GuppyTrix/Comp208/documentation/Images/Full design.png

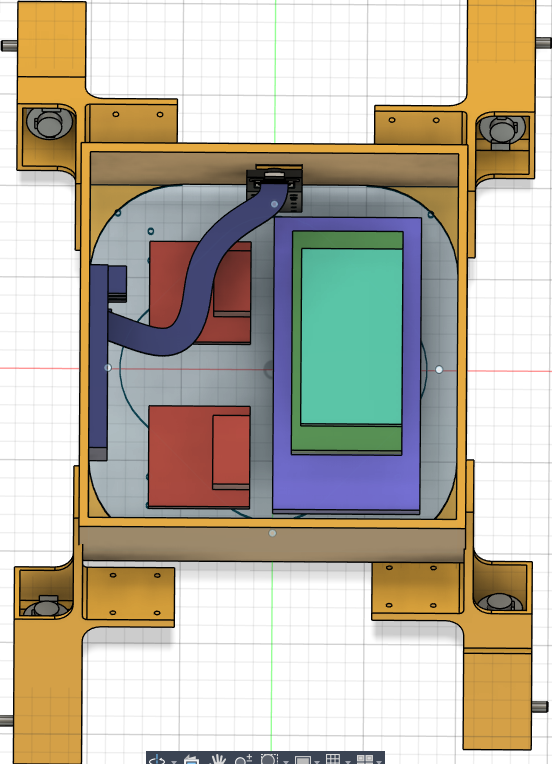
documentation/Images/Full design.png
