GuppyTrix/Comp208/CAD/readme.md

# CAD

Please add Fusion Files and screenshots/exported images of completed designs
