GuppyTrix/Comp208/code/readme.md

# Code

Please include all code files in the form of C++ (Arduino INO) and/or Python or Micropython files.
