GuppyTrix/Comp208/documentation/readme.md

# Documentation

Please add videos and images of your robot prototype here.
