GuppyTrix/Comp208/poster/poster trial.docx

Part D

Formative Poster Submission

Part D is a single formative submission consisting of a poster that explains your mobile robot. The poster should explore the following elements:

Locomotion

How do you plan to make your robot move?

What experiments with engineering and materials will you undertake to achieve effective movement?

Sensing & Navigation

How will your robot sense its environment?

How will it interpret feedback from its sensors to adapt or change its behaviour in order to achieve its goals?

Analysis

How will you analyse the data produced by your robot to enable rapid, iterative development?

What tools will you use to perform this analysis?

What data will you use to determine how well your robot operates?

Research

Demonstrate your understanding of key concepts in Robotics and Cybernetics, and explain how they are embedded in your project.

Include quotations and references to your research, using IEEE citations from at least three academic papers or other scholarly sources.

You should also include some or all of the following elements:
i. Diagrams
ii. Mathematical notation
iii. Algorithms
iv. Engineering and CAD designs

Note: Your research should be presented both in your poster and in your repository README.

Materials

What components and materials are needed to build your robot?

How do you plan to select, source, and construct with these materials?

# Abstract

Ever lost your can of coke, had no idea where to find it. Here with the Can finder It stores images of your can and using a camera won't stop until it finds it. Whether it's outside, inside or in the glove department the Can Finder won't stop until it finds it.
