GuppyTrix/Comp208/poster/JarethSubmissionStuff/Poster_For_Comp_208_Scrabbling.pdf

# Autonomous Rough-Terrain Robot for Object Retrieval

# Scrabbling Contract Implementation

# Jareth Haydon-Guppy

# COMP208: Robotics & Cybernetics Falmouth University

# Abstract

This project addresses the Scrabbling Contract challenge: designing an autonomous robot capable of navigating rough outdoor terrain (grass and rubble across 15m²
) to locate a drink can, report arrival, and return to its starting point. The robot employs a four-wheel drive system with foam-filled rubber RC wheels powered by 12V DC motors (1:64 gear reduction, 40RPM) for optimal terrain adaptability. Using a Raspberry Pi 5 with Pi Camera Module 3 and OpenCV-based color detection, the robot identifies red cans with high accuracy. A Finite State Machine (FSM) architecture controls autonomous navigation with encoder-based odometry for precise movement tracking. The system successfully demonstrates cybernetic principles of feedback and goal-oriented behavior in unstructured environments.

Figure 1: Final Design of the robot

# Introduction & Contract Overview

- Contract: Scrabbling - Navigating rough outdoor terrain to locate and approach a drink can
- Environment: 15m² arena with grass and rubble (chaotic, changing surface)
- Primary Goal: Autonomously locate and approach a vertical drink can
- Secondary Goal: Return to starting point and signal task completion
- Key Constraint: Fully autonomous operation with error reporting
- Cybernetic Focus: Feedback loops for environmental adaptation and goal achievement

# Research & Theoretical Framework

- Cybernetics Principle: "For any machine subject to a varied external environment to act effectively information concerning the results of its own action must bebe furnished to it as part of the information on which it must continue to act." - Norbert Wiener
- Sensor Fusion Theory: Integration of visual (camera) and proprioceptive (encoder) feedback for robust perception
- Finite State Machines: Formal method for autonomous behavior sequencing and decision-making
- Computer Vision: Color space analysis and object detection in unstructured environments [1]

# Materials & Fabrication

- Core Components:

– 4 × 12V DC motors with built-in encoders (1:64 worm gear, 100RPM)
– 2 × L298N H-bridge motor drivers
– Arduino Mega 2560 microcontroller
– Raspberry Pi 5 with Pi Camera Module 3 – 12V LiPo battery pack
– 4 × Foam-filled rubber RC wheels
- Custom Fabrication:

– 3D-printed motor mounts and wheel adapters (Fusion 360)
– Acrylic base plate with custom mounting points – 3D-printed protective enclosure for electronics – Custom dimension documentation for encoder motors
- Fasteners: M3 bolts and nuts throughout assembly

# Technical Implementation

## Locomotion System

Wheel Selection: Foam-filled rubber RC wheels provide optimal traction on uneven surfaces without pneumatic complications. Motor Configuration: 12V DC motors with 1:64 gear reduction deliver 100RPM with high torque for rough terrain. Drive Train: Direct drive connection via 3D-printed adapters (no belts or additional gearing). Design Rationale: Four-wheel distribution minimizes individual axle load; direct drive simplifies mechanical design while maintaining sufficient torque.

## Sensing & Computer Vision

- Vision System: Raspberry Pi 5 with Pi Camera Module 3
- Detection Algorithm:
1. Colour space conversion to HSV for robust red color detection
2. Morphological operations to reduce noise
3. Contour detection and aspect ratio validation (0.7-1.2 tolerance for angled cans)
4. Three-frame verification with 0.2s intervals to prevent false positives
5. Bounding box area threshold for arrival determination
- Search Pattern: Systematic left-right scanning with periodic stops for clear image capture
- Future Enhancement: Ultrasonic sensor integration for tree/obstacle detection

## Control Architecture

- Three-Class System: Robot class: High-level control methods, FSM class: Finite State Machine for behaviour sequencing and Odometry class: Encoder-based position tracking (4 instances, one for each motor)
- State Machine Design:
Searching | Homing

Arrived

Can detected

Lost target

Area threshold reached

Reset activated

- Communication Protocol: GPIO pins (left, right, found, arrived) between RPi and Arduino
- Precision Movement: Encoder-based turning and distance measurement for accurate navigation

## Odometry Calculation

- D = Wheel diameter
- N = Encoder ticks per revolution
- G = Gear Ratio
- E = Encoder Resolution
- L = Wheelbase distance
- θ = Robot orientation
- C = Wheel Circumference

Ticks per degree =

G × E
360

=

63 × 44
360

=

2772
360

= 7.7 ticks/°

Distance per degree =

C
360

=

100π
360

≈ 0.8727 mm/°

Distance per tick =

C
G × E

=

100π
63 × 44

=

100π
2772

≈ 0.1133 mm/tick

### Color Detection Algorithm:

Convert RGB to HSV colour space
Apply threshold for red hues: H ∈ [0, 10] ∪ [170, 180] Find contours and calculate bounding boxes Filter by aspect ratio: 1.2 ≤

w
h ≤ 1.3
Time-based three-frame verification

# Analysis & Iterative Development

- Prototyping Phases:
1. Initial testing with various wheel sizes and flanges on 8mm rods
2. Gear reduction experiments (1:2.5 custom gearing, belt systems)
3. Final design: Direct drive with custom 3D-printed adapters
- Data Collection:
– Detection accuracy under varying lighting conditions
– Terrain navigation success rates on grass, rubble, loose leaves, mud, apples – Encoder accuracy and odometry drift correction
- Iterative Improvements:
– Added three-frame verification to reduce false positives
– Implemented aspect ratio tolerance for consistent and angled detection
– Refined state transitions based on field testing
In Figure 2 i have a design of the robot color coded for easy description of the parts in the robot the Yellow is the case of the robot designed to hold all of the parts together including the encoders. The Red are the H-Bridges which control the motors wheel direction. there are cables connected to the motors and to the Arduino. The light blue is the Arduino, we used an Arduino Mega 2560 in this project. The green is the NI-MH battery pack that was used to power the motors as the power from the Arduino would not be high enough and the purple box underneath the green box is the battery pack used to power the Arduino and The Raspberry Pi. The Raspberry Pi can be seen as the dark purple which had a connector to the camera module at the front of the robot

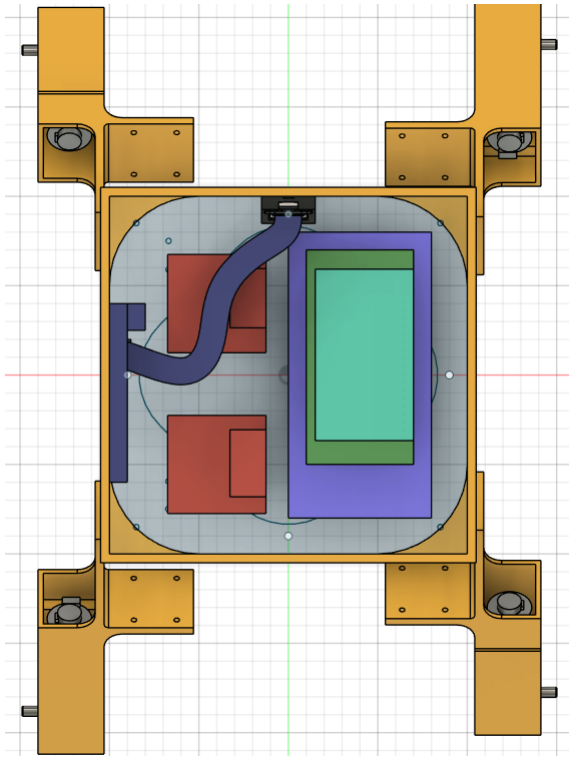
[picture p2: figure]

Figure 2: Full Robot Design in CAD colour coded

# Results & Evaluation

## Key Achievements

- Successfully located cans in trials under good lighting
- Robust detection with three-frame verification system
- Precise encoder-based movement control with odometry tracking
- Clear arrival signaling with buzzer activation

## Design Decisions & Rationale

- Foam-filled wheels: Eliminated pneumatic maintenance while maintaining traction
- Direct drive: Simplified mechanical design with sufficient torque for terrain
- Dual-processor architecture: Arduino for real-time motor control, RPi for computer vision
- State machine design: Clear separation of behaviors with defined transitions
- Three-frame verification: Balanced responsiveness with noise immunity

# Conclusion

The Scrabbling Contract robot successfully demonstrates the application of cybernetic principles to autonomous navigation in unstructured environments. Key achievements include robust can detection using computer vision, precise encoder-based navigation, and a reliable state machine architecture. The robot meets all contract requirements while employing sustainable design practices through 3D printing and component reuse. Future enhancements could include ultrasonic obstacle avoidance, wireless telemetry for status reporting, and machine learning for improved object recognition.

# Acknowledgments

Thanks to the COMP208 teaching team for technical guidance and access to fabrication facilities. Special thanks to Freddie for collaborative design iterations and some excellent ideas. Fusion 360 was used for CAD design under educational license.

# References

[1] F. Neha, D. Bhati, D. K. Shukla, and M. Amiruzzaman, “From classical techniques to convolution-based models: A review of object detection algorithms,” arXiv, Dec. 2024. DOI: 10.48550/arXiv.2412.05252. [Online]. Available: https://arxiv.org/abs/2412.05252.
