GuppyTrix/Comp208/CAD/Camera/Body1.stl

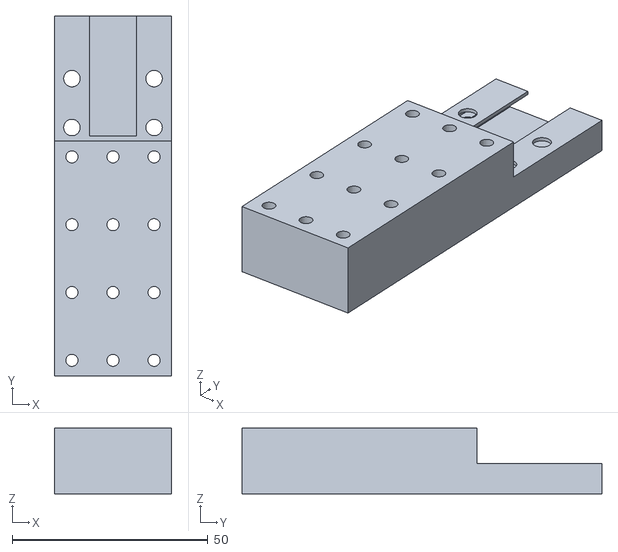
[picture p3: CAD file, 2025-12-11]
CAD/Camera/Body1.stl
30.0 x 92.0 x 16.8
