GuppyTrix/Comp208/CAD/Gears & Wheels/Gear Tolerances.stl

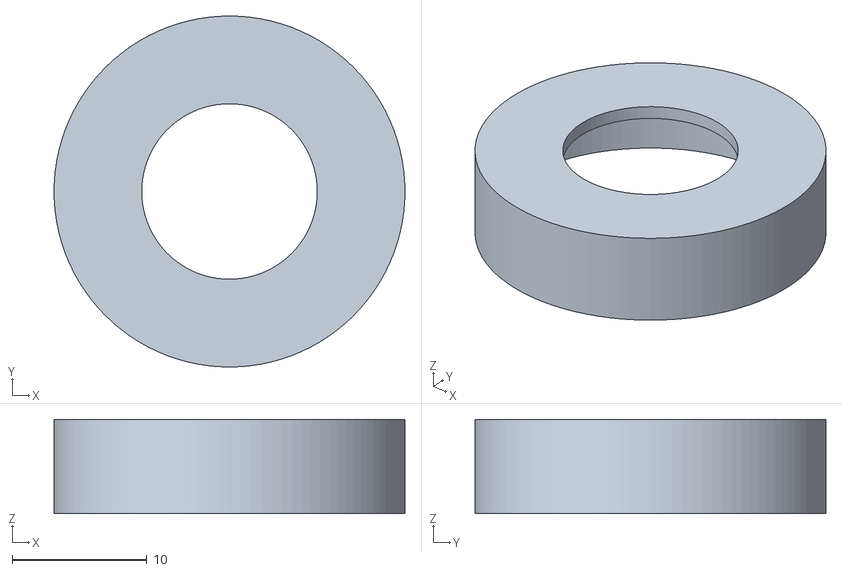
[picture p4: CAD file, 2025-11-27]
CAD/Gears & Wheels/Gear Tolerances.stl
26.0 x 26.0 x 7.00
