GuppyTrix/Comp208/CAD/LDR Casing v3.stl

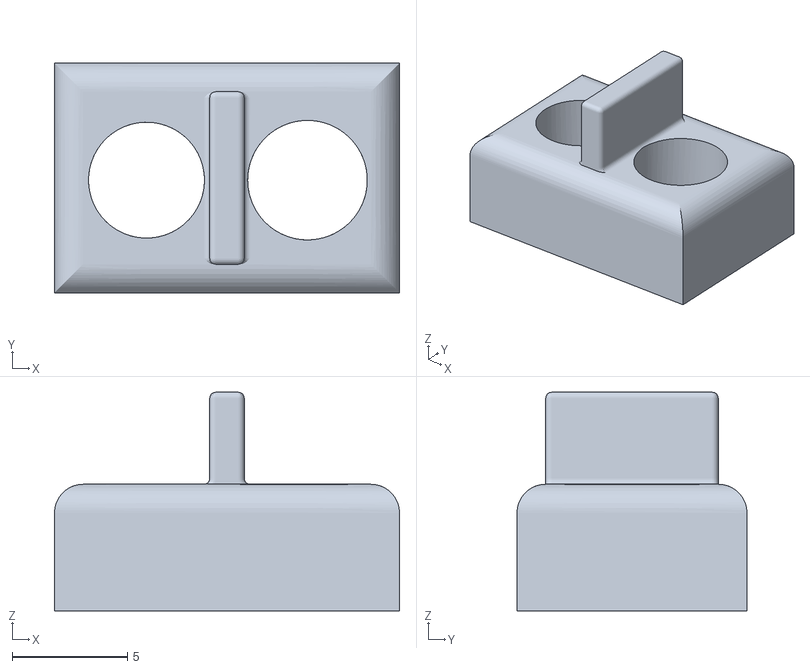
[picture p5: CAD file, 2025-11-06]
CAD/LDR Casing v3.stl
15.0 x 10.0 x 9.50
