GuppyTrix/Comp208/CAD/Motors/Encoder Clearance Holder.stl

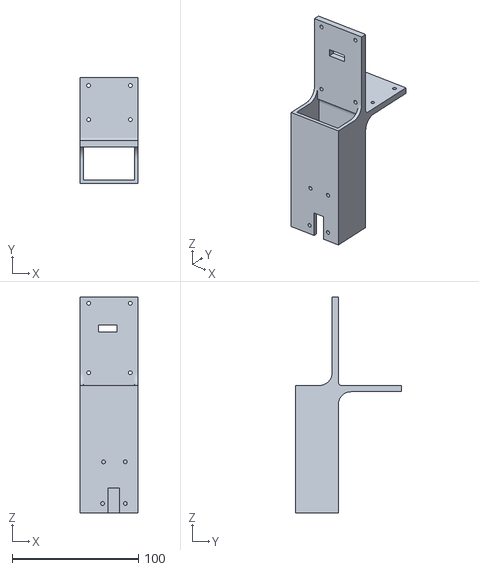
[picture p6: CAD file, 2025-12-09]
CAD/Motors/Encoder Clearance Holder.stl
46.0 x 84.0 x 171.0
