GuppyTrix/Comp208/CAD/Motors/motor holder.3mf

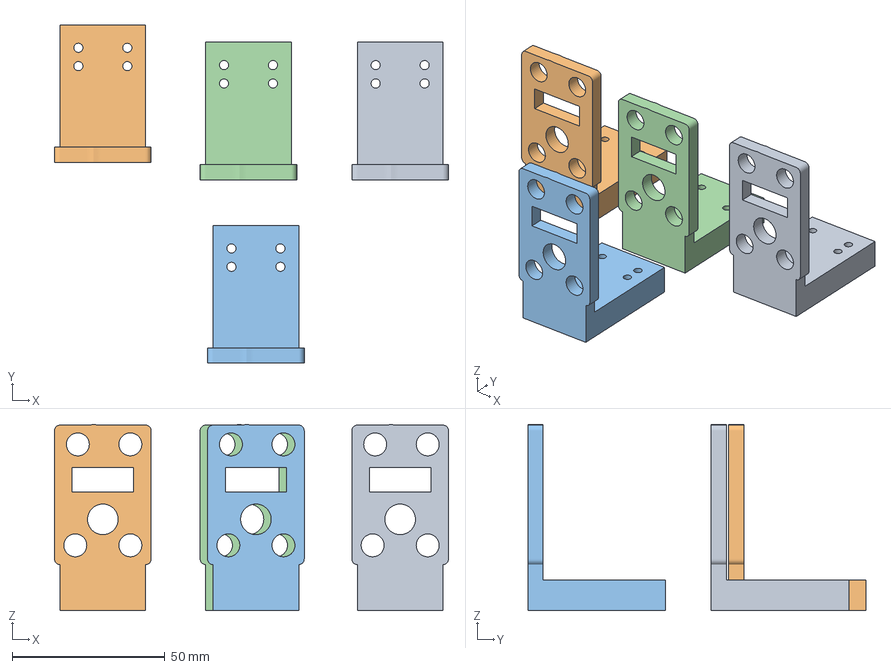
[picture p7: CAD file, 2025-12-03]
CAD/Motors/motor holder.3mf
128.8 x 110.6 x 60.8 mm
motor holder.stl x 4
