GuppyTrix/Comp208/CAD/Motors/207 base.dxf

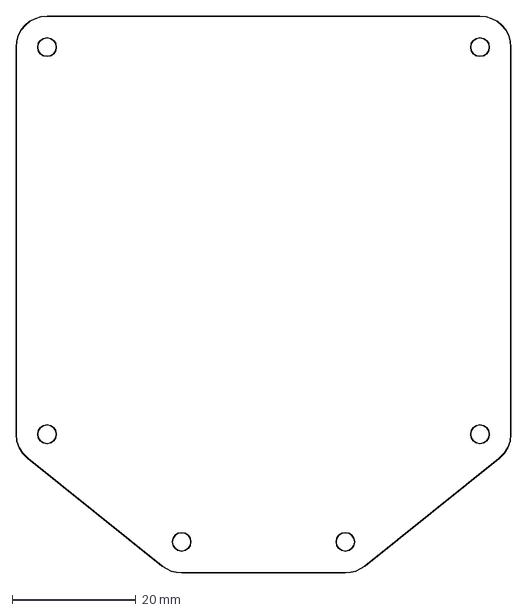
[picture p8: CAD file, 2025-11-29]
CAD/Motors/207 base.dxf
80.0 x 90.0 mm
