GuppyTrix/Comp208/CAD/Motors/finalized jareth version.3mf

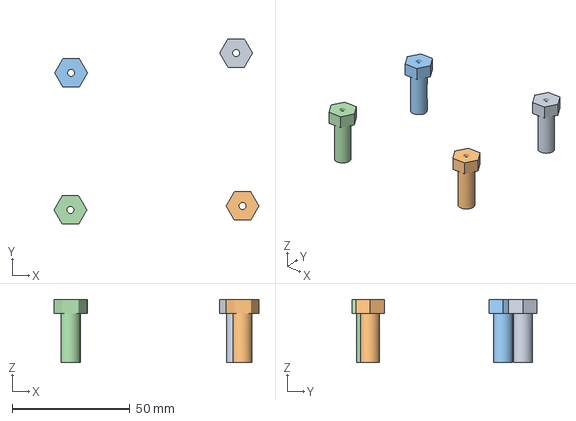
[picture p9: CAD file, 2025-11-29]
CAD/Motors/finalized jareth version.3mf
87.2 x 78.9 x 27.0 mm
finalized jareth version.stl x 4
