GuppyTrix/Comp208/CAD/Motors/encoder holder.dxf

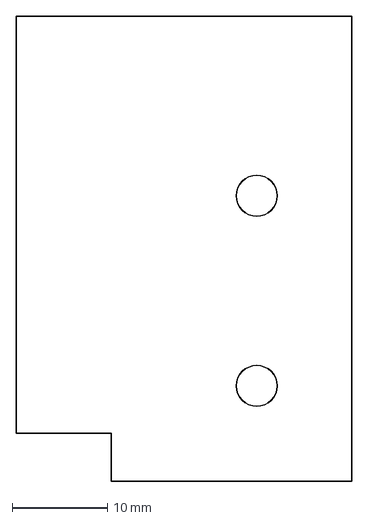
[picture p10: CAD file, 2025-11-27]
CAD/Motors/encoder holder.dxf
35.3 x 48.9 mm
