GuppyTrix/Comp208/CAD/Motors/smaller washer for holding in place.stl

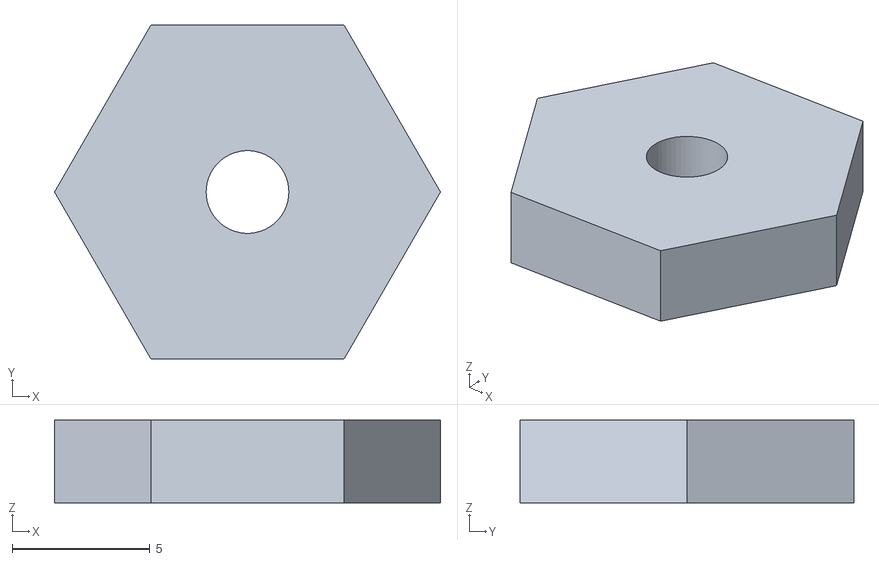
[picture p11: CAD file, 2025-12-03]
CAD/Motors/smaller washer for holding in place.stl
14.0 x 12.1 x 3.00
