GuppyTrix/Comp208/CAD/Motors/bolt for wheels.dxf

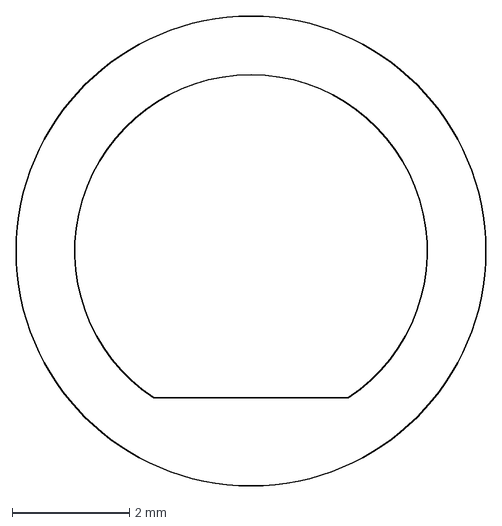
[picture p12: CAD file, 2025-11-27]
CAD/Motors/bolt for wheels.dxf
8.00 x 8.00 mm
