GuppyTrix/Comp208/(list of files, cad)

Other CAD files:
CAD/Motors/Wheel axel connector.f3d
CAD/Motors/motor holder.stl
CAD/shell/Full Box Design.f3z
CAD/shell/chassis take 2.f3z
