GuppyTrix/Comp208/poster/Jareth Submission stuff/Jareth-Comp-208-Devlog/Comp 208 devlog 2795be74c30880d0a1c4d0de6863eb3a.pdf

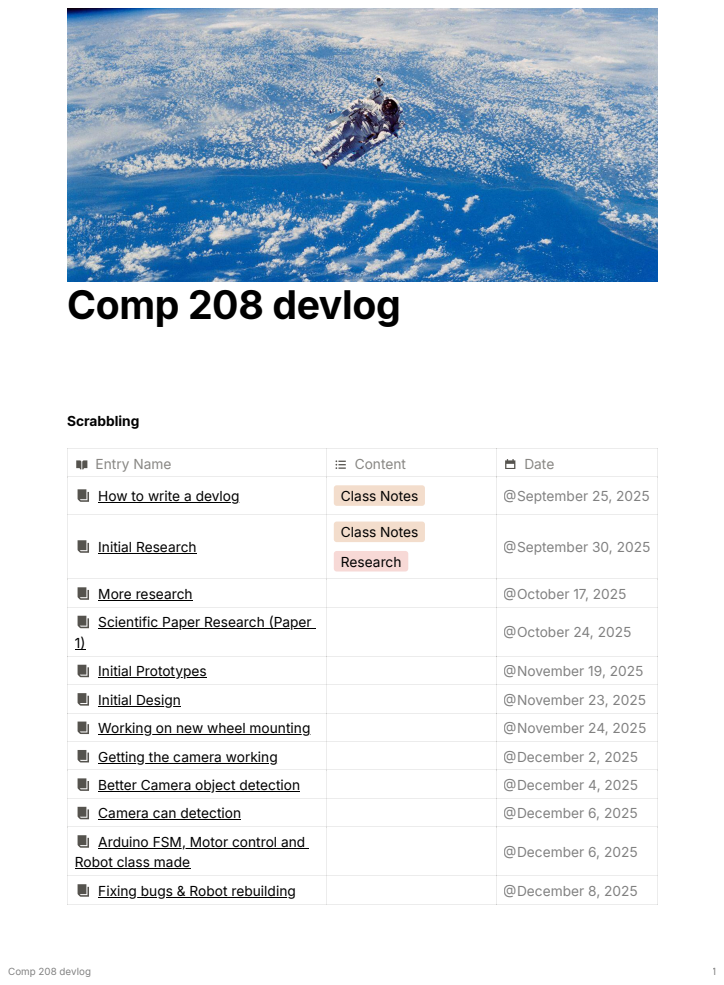
[picture p13: page 1]
Comp 208 devlog; Scrabbling; Entry Name; Content; Date; September 25, 2025 @; September 30, 2025 @; October 17, 2025 @; October 24, 2025 @; November 19, 2025 @; November 23, 2025 @; November 24, 2025 @; December 2, 2025 @; December 4, 2025 @; December 6, 2025 @; December 8, 2025 Comp 208 devlog

How to write a devlog (https://www.notion.so/How-to-write-a-devlog-2cb5be74c3088127a520ef2aea5b9929?pvs=21) | Class Notes

Initial Research (https://www.notion.so/Initial-Research-2cb5be74c308811fbf50c0e0c553caf0?pvs=21) | Class Notes Research

More research (https://www.notion.so/More-research-2cb5be74c3088161baeeeb874f951d66?pvs=21)
Scientific Paper Research (Paper 1) (https://www.notion.so/Scientific-Paper-Research-Paper-1-2cb5be74c30881739049ea7695071078?pvs=21)

Initial Prototypes (https://www.notion.so/Initial-Prototypes-2cb5be74c30881e589d9d2a5f8bcf9ee?pvs=21)
Initial Design (https://www.notion.so/Initial-Design-2cb5be74c30881f289c0d6c7474cb86d?pvs=21)
Working on new wheel mounting (https://www.notion.so/Working-on-new-wheel-mounting-2cb5be74c308814c9904e42dfc15a79c?pvs=21)
Getting the camera working (https://www.notion.so/Getting-the-camera-working-2cb5be74c30881e691eae9727fa10bfa?pvs=21)
Better Camera object detection (https://www.notion.so/Better-Camera-object-detection-2cb5be74c30881c382dce5bf9b646814?pvs=21)
Camera can detection (https://www.notion.so/Camera-can-detection-2cb5be74c308819abd0ff79c5a6959ca?pvs=21)
Arduino FSM, Motor control and Robot class made (https://www.notion.so/Arduino-FSM-Motor-control-and-Robot-class-made-2cb5be74c3088186947fe69ddc9f02ba?pvs=21)

Fixing bugs & Robot rebuilding (https://www.notion.so/Fixing-bugs-Robot-rebuilding-2cb5be74c30881989d82fe625edd5869?pvs=21)

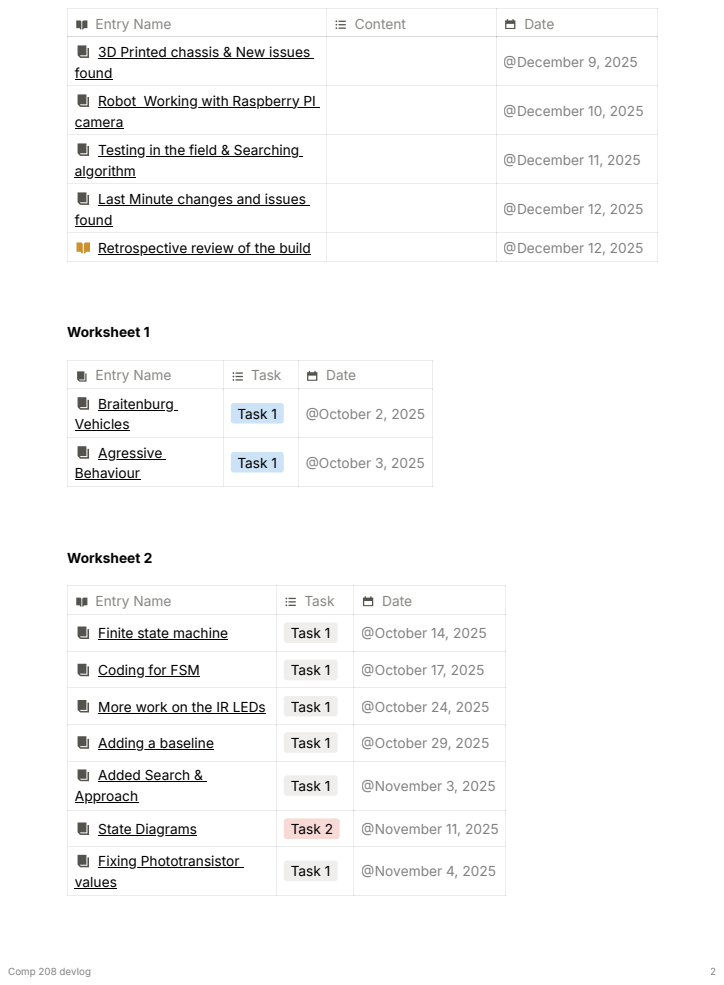
[picture p14: page 2]
Entry Name; Content; Date; Worksheet 1; Task; Worksheet 2; December 9, 2025 @; December 10, 2025 @; December 11, 2025 @; December 12, 2025 @; October 2, 2025 @; October 3, 2025 @; October 14, 2025 @; October 17, 2025 @; October 24, 2025 @; October 29, 2025 @; November 3, 2025 @; November 11, 2025 @; November 4, 2025 Comp 208 devlog

3D Printed chassis & New issues found (https://www.notion.so/3D-Printed-chassis-New-issues-found-2cb5be74c308816fa553f33e7964c2e2?pvs=21)

Robot Working with Raspberry PI camera (https://www.notion.so/Robot-Working-with-Raspberry-PI-camera-2cb5be74c30881d3b7e6e34f6371d449?pvs=21)

Testing in the field & Searching algorithm (https://www.notion.so/Testing-in-the-field-Searching-algorithm-2cb5be74c30881fa8cadfc72ab0cecde?pvs=21)

Last Minute changes and issues found (https://www.notion.so/Last-Minute-changes-and-issues-found-2cb5be74c30881509e6dfeeaff751a58?pvs=21)

Retrospective review of the build (https://www.notion.so/Retrospective-review-of-the-build-2cb5be74c30881d6a68cfc4c6df7d66f?pvs=21)

Braitenburg Vehicles (https://www.notion.so/Braitenburg-Vehicles-2cb5be74c30881de8a02ed7190a3dbe6?pvs=21) | Task 1

Agressive Behaviour (https://www.notion.so/Agressive-Behaviour-2cb5be74c308810ebce8c4f3feee3c0c?pvs=21) | Task 1

Finite state machine (https://www.notion.so/Finite-state-machine-2cb5be74c30881da9b71c4291b8a3b9e?pvs=21) | Task 1

Coding for FSM (https://www.notion.so/Coding-for-FSM-2cb5be74c3088121bc3ffe1077e5503e?pvs=21) | Task 1

More work on the IR LEDs (https://www.notion.so/More-work-on-the-IR-LEDs-2cb5be74c30881a88f6fd68fc78efd3e?pvs=21) | Task 1

Adding a baseline (https://www.notion.so/Adding-a-baseline-2cb5be74c3088156af89fa81c1183bad?pvs=21) | Task 1

Added Search & Approach (https://www.notion.so/Added-Search-Approach-2cb5be74c3088145ad69f88277c27439?pvs=21) | Task 1

State Diagrams (https://www.notion.so/State-Diagrams-2cb5be74c30881869922e9abde0b3912?pvs=21) | Task 2

Fixing Phototransistor values (https://www.notion.so/Fixing-Phototransistor-values-2cb5be74c308818eafd8fb7cb13e54e6?pvs=21) | Task 1

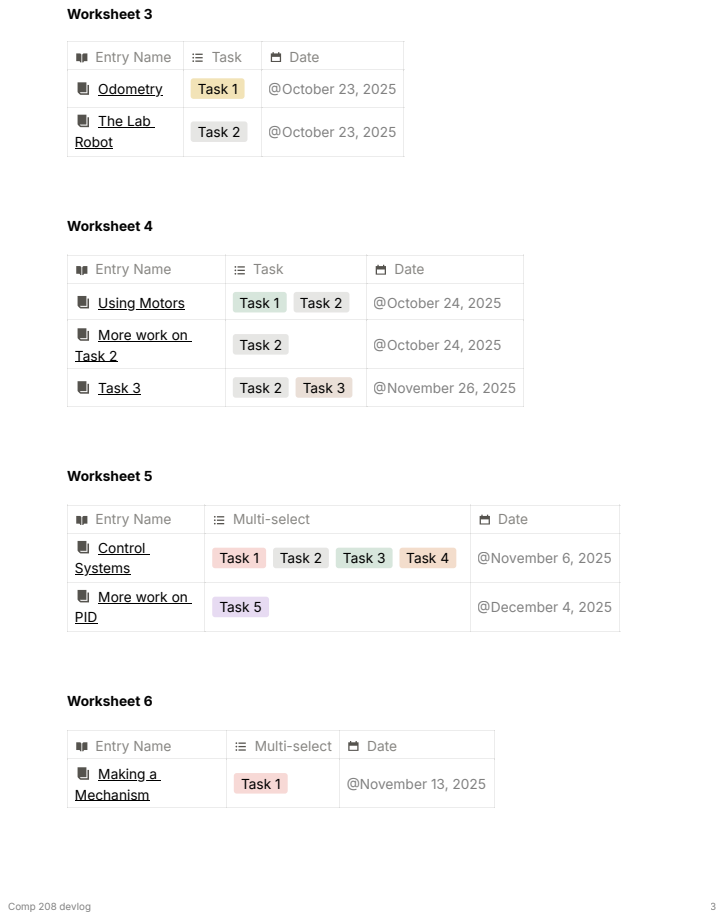
[picture p15: page 3]
Worksheet 3; Entry Name; Task; Date; Worksheet 4; Worksheet 5; Multi-select; Worksheet 6; Making a Mechanism; Task 1; October 23, 2025 @; October 24, 2025 @; November 26, 2025 @; November 6, 2025 @; December 4, 2025 @; November 13, 2025 Comp 208 devlog

Odometry (https://www.notion.so/Odometry-2cb5be74c30881599b50dfe5028639c8?pvs=21) | Task 1

The Lab Robot (https://www.notion.so/The-Lab-Robot-2cb5be74c30881e5b100f9c9e8f8b5f3?pvs=21) | Task 2

Using Motors (https://www.notion.so/Using-Motors-2cb5be74c3088183ab7cd6b2263e507f?pvs=21) | Task 1 Task 2

More work on Task 2 (https://www.notion.so/More-work-on-Task-2-2cb5be74c3088136b59acfd63b89363d?pvs=21) | Task 2

Task 3 (https://www.notion.so/Task-3-2cb5be74c308811babb4dfaad9edf8d2?pvs=21) | Task 2 Task 3

Control Systems (https://www.notion.so/Control-Systems-2cb5be74c30881e0a1ffcd1bb1e71592?pvs=21) | Task 1 Task 2 Task 3 Task 4

More work on PID (https://www.notion.so/More-work-on-PID-2cb5be74c30881fc9e27c2d834b5a0dd?pvs=21) | Task 5

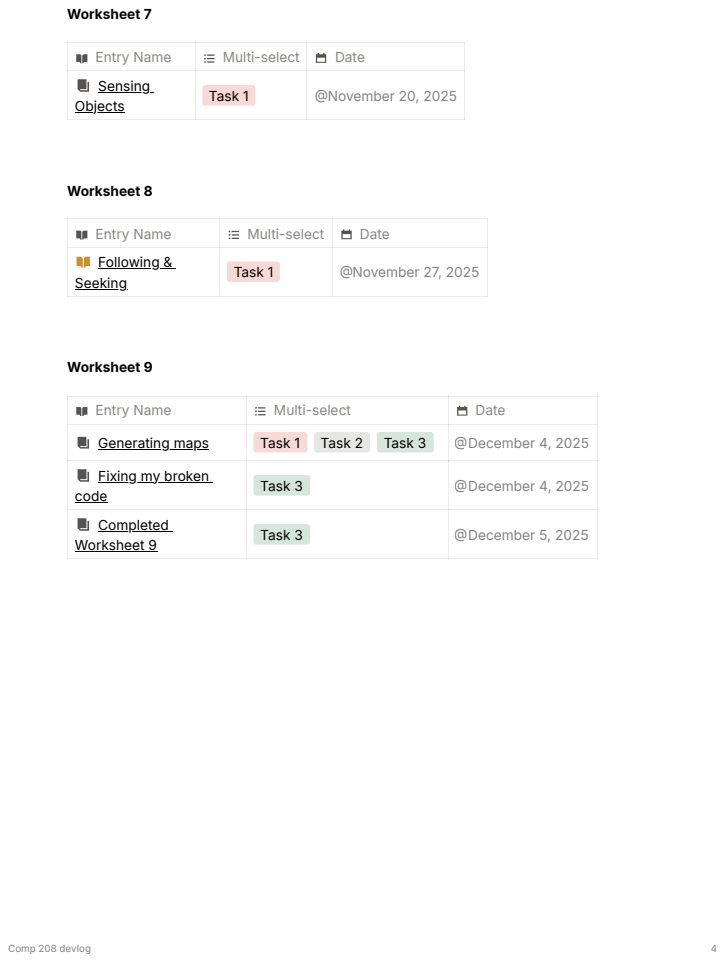
[picture p16: page 4]
Worksheet 7; Entry Name; Multi-select; Date; Sensing Objects; Task 1; Worksheet 8; Following & Seeking; Worksheet 9; November 20, 2025 @; November 27, 2025 @; December 4, 2025 @; December 5, 2025 Comp 208 devlog

Generating maps (https://www.notion.so/Generating-maps-2cb5be74c3088160a6dec0c7edc7d1f5?pvs=21) | Task 1 Task 2 Task 3

Fixing my broken code (https://www.notion.so/Fixing-my-broken-code-2cb5be74c30881e983cfed3376d3a736?pvs=21) | Task 3

Completed Worksheet 9 (https://www.notion.so/Completed-Worksheet-9-2cb5be74c308816a8a68fce99e161d9e?pvs=21) | Task 3
