GuppyTrix/Comp208/documentation/Schematic_208-wiring-diagram_2025-12-01.pdf

# GND +5V 5052 4749

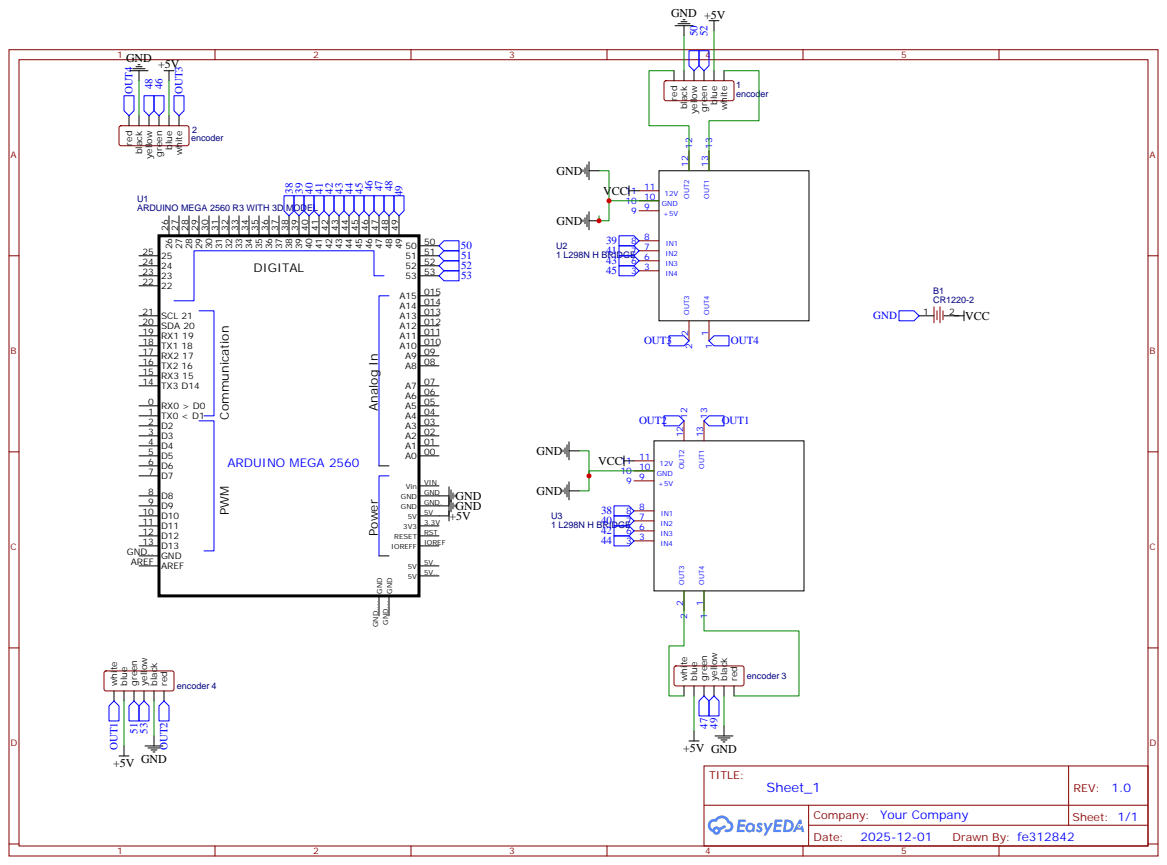
[picture p17: page 1]
