GuppyTrix/Comp208/CAD/Motors/12 volt motor holders Drawing v1.pdf

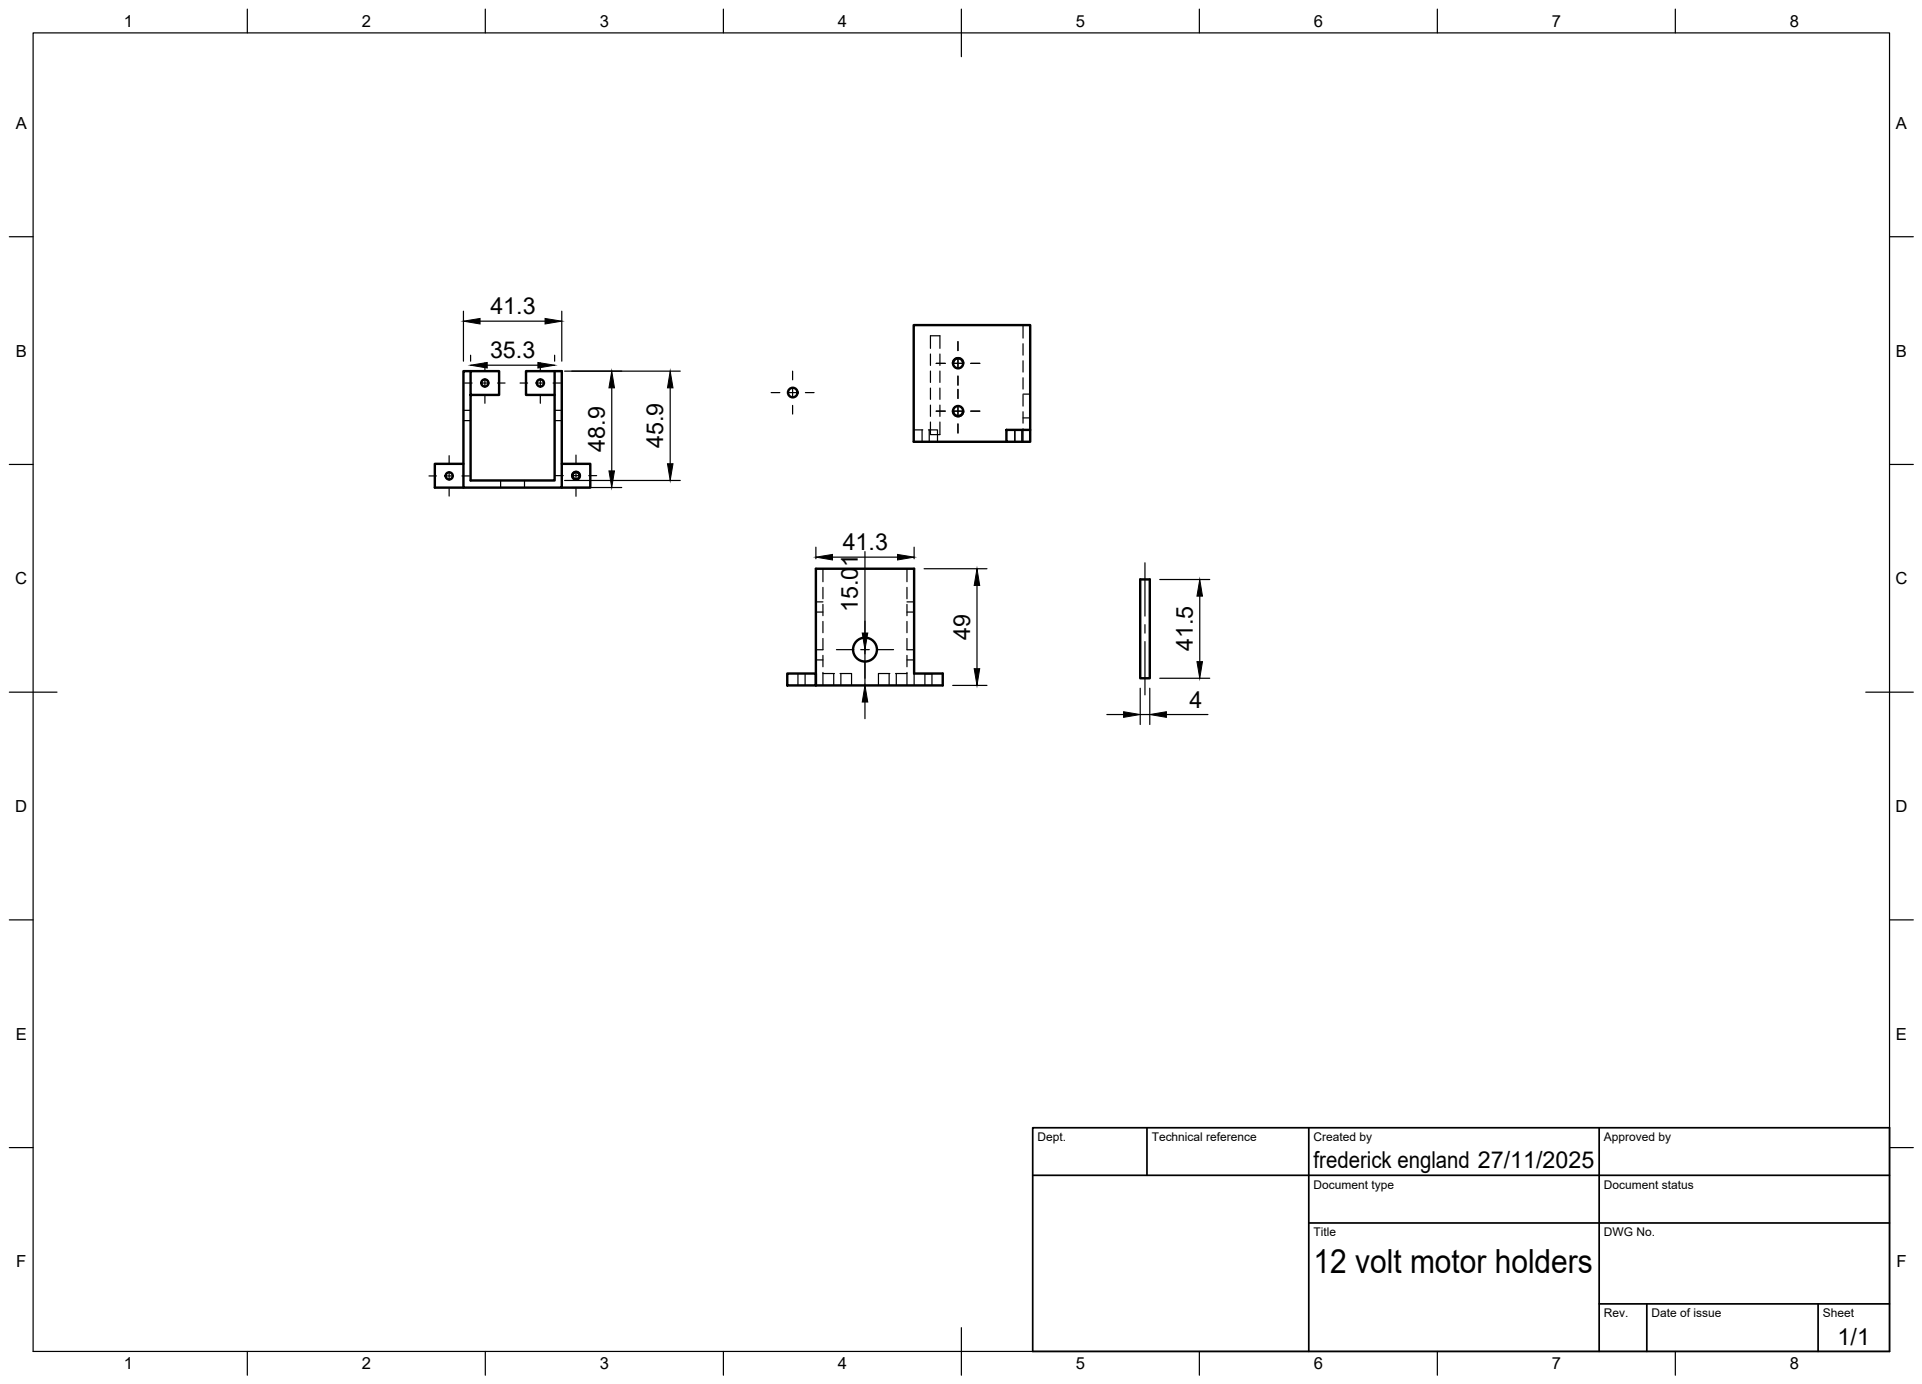
[picture p18: page 1]
Title; DWG No.; Rev.; Date of issue; Sheet; frederick england 15.01

Dept. | Technical reference | Created by 27/11/2025 | Approved by

Document type | Document status

12 volt motor holders
