GuppyTrix/Comp208/documentation/12v dc reduciton Motor Technical drawing.pdf

46 39 18

33 ³² 2 21 | 1412 | Ø13.4 | Ø25 Ø3 Ø7.5 ¹⁶

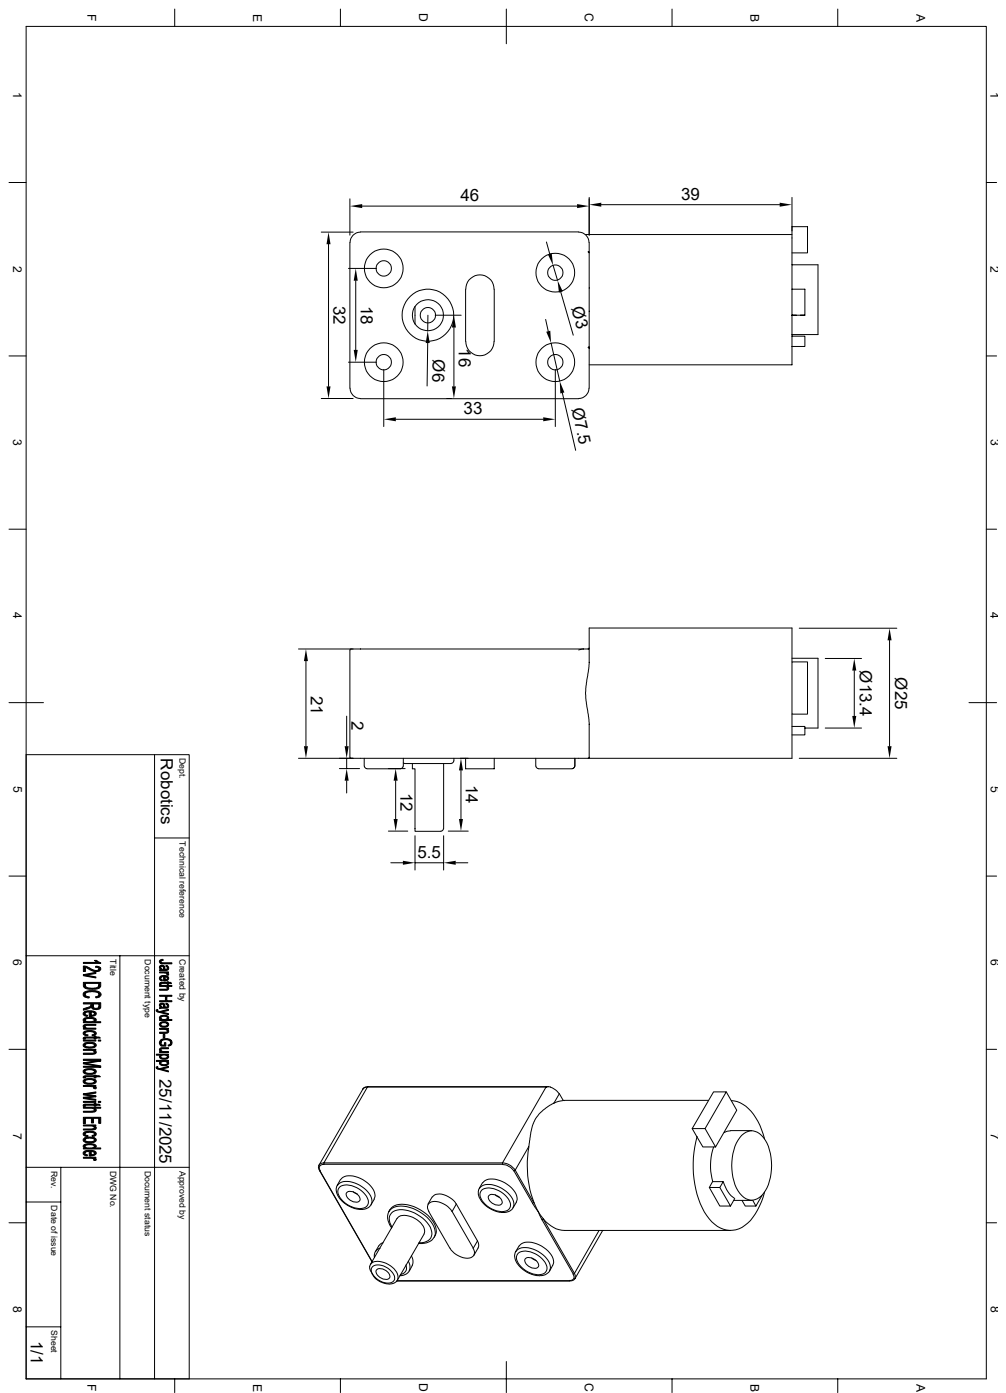
[picture p19: page 1]
5.5Ø6 Robotics

1 A 2 3 4 5 6 7 8 1 2 3 4 5 6 7 8 FEDCB FEDCBA Dept. Technical reference Created by Approved by Title DWG No. Document type Document status Rev. Date of issue Sheet 25/11/2025 1/1
