GuppyTrix/Comp208/(list of files, drawings)

Other design files:
CAD/SCH_208-Brab-Putt_2025-11-09.json
