GuppyTrix/Comp208/(commit log)

2025-10-23 Worked with Jareth on this rpm and torque calculation code
2025-11-06 Added: Phototransistor and IR led casing STL
2025-11-06 trialing BANGBANG code
    Added what i interpret currently as bang bang code
2025-11-06 Modified: completed the Bang Bang motor drive method
2025-11-09 trialing pcb design
2025-11-10 sent in some sample code that might help with task 5
2025-11-11 trying to get the code compiled
    since it's an arduino goign to a raspberry pi it's struggling to compile
2025-11-14 added velocity code and trying to get it to upload to lab bot
2025-11-20 Modidied: Simple state code
    added an avoid obstacle case to the state machine
2025-11-20 continued work on encoder practice
2025-11-20 Modified: moved torquecalc
2025-11-25 Added: modeled the 12v DC Motor
2025-11-27 added improved ultrasonic code
2025-11-27 modified the wall follwer code to use all 3 sensors
2025-11-27 finished making designs for the encoder and bolts ready for print
    Ready for print after Jareths review
2025-11-29 added CAD files for evidence
2025-12-03 Added more CAD files for printing and iteration
2025-12-03 Added basic movement script for arduino
2025-12-03 Added the arduino wiring diagram for poster and review
2025-12-04 Created new code for PID in worksheet 5
2025-12-04 Modified bad logic fixed and other issues
    - fixed infilit loop issue in a for loop for go straight
    - fixed floating point division issue at for ticks per degree
    - fixed division multiplication order issue
    - fixed pin decleration issues
2025-12-04 Modified bad logic fixed and other issues
    - fixed infinite loop issue in a for loop for go straight
    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
2025-12-05 Completed Task 3
    - Added a way for the motors to stop when reaching their goal
    - Added new method to stop a single motor
    - Added Variables at the top of the code for turn amount and forward amount
2025-12-06 Moved movement base
    moved freddies motor testing code into the scrabble bot code folder
2025-12-06 Created Motor control and pin cna sensing
    in this code i created 3 classes
    - Robot
    - FSM
    - Odometry
    the odometry class is what im using to control the motors should probably rename to be motor odometry as it does both odometry and motor control
    FSM which controls which state the robot is in and sets what the robot should be doing
    Robot controls the motors together
    how the code works:
    i create 4 instances of the class odometry for each of the motors using these classes we can control each of the motors individualy if we want
    the motors are then given to an instance of the robot class which controls the motors in sync with each other to complete a task eg: move forward or turn ect...
    fin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
2025-12-06 changed to improve code wiring
    went back to the more accurate declaration
2025-12-06 tried Bens version of motor movement code
2025-12-06 Made new code to detect a coke can
    currently it can detect a can fairly well i need to add some logic that looks close and far to see if anything changes
    if nothing found then report nothing, if it detects something far then get cloder and double check to see if its actually a can
2025-12-07 Made advanced can detection with gpio ouput the code now has more advanced can detection using open cv i also in the output display i created visualisation of what the code is doing its untested at t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
2025-12-07 finalizing script with correct wiring configuration
2025-12-07 Unfortunately its working but without encoders
2025-12-08 More changes on PID
    i did my best to get pid to work but i cant seem to get any of the values honed in at all but i added
2025-12-08 Fixed 11 issues in Prototype
    1.Incorect motor power pins
    2.Incorrect wheel diameter
    3.Incorrect wheel base
    4.Incorrect can detection pins
    5.Incorrect encoder pins
    6.The wheels dont use PWM pins do the drive motor method didnt work, changed the code to work
    7.Removed redundant variable checking that was causing an issue with he code running
    8.Added a flat move method that will move until told other wise, added this so that i dont have issues with motors thinking they have completed the movement
    9.Added more value checking before the FSM gets put in the arrived state
    10.Fixed the FSM so that the boolean logic is actually correct
    11.Changed the classes so they dont use as many references and po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
2025-12-09 Found the new Pins for the Motors
    const int motor3a = 38;
    const int motor3b = 40;
    const int motor1a = 41;
    const int motor1b = 39;
    const int motor2a = 43;
    const int motor2b = 45;
    const int motor4a = 42;
    const int motor4b = 44;
    Encoder FL_motor(20, 21);
    Encoder FR_motor(18, 19);
2025-12-09 changing pin numbers
2025-12-09 added chasis to CAD
2025-12-09 Created Motor holder for clearance
2025-12-10 New parts designed for the encoders
2025-12-11 created a camera mount
2025-12-11 Found new PI camera pins
2025-12-11 reset pins to pwm
2025-12-16 accidentaly deleted my pdf at sompoint in the last couple commits
